felix-eray/ESP32_blAudio_lite/KiCad/ESP32_blAudio_portable.kicad_pcb

## KiCad design KiCad/ESP32_blAudio_portable.kicad_pcb (2022-10-03)

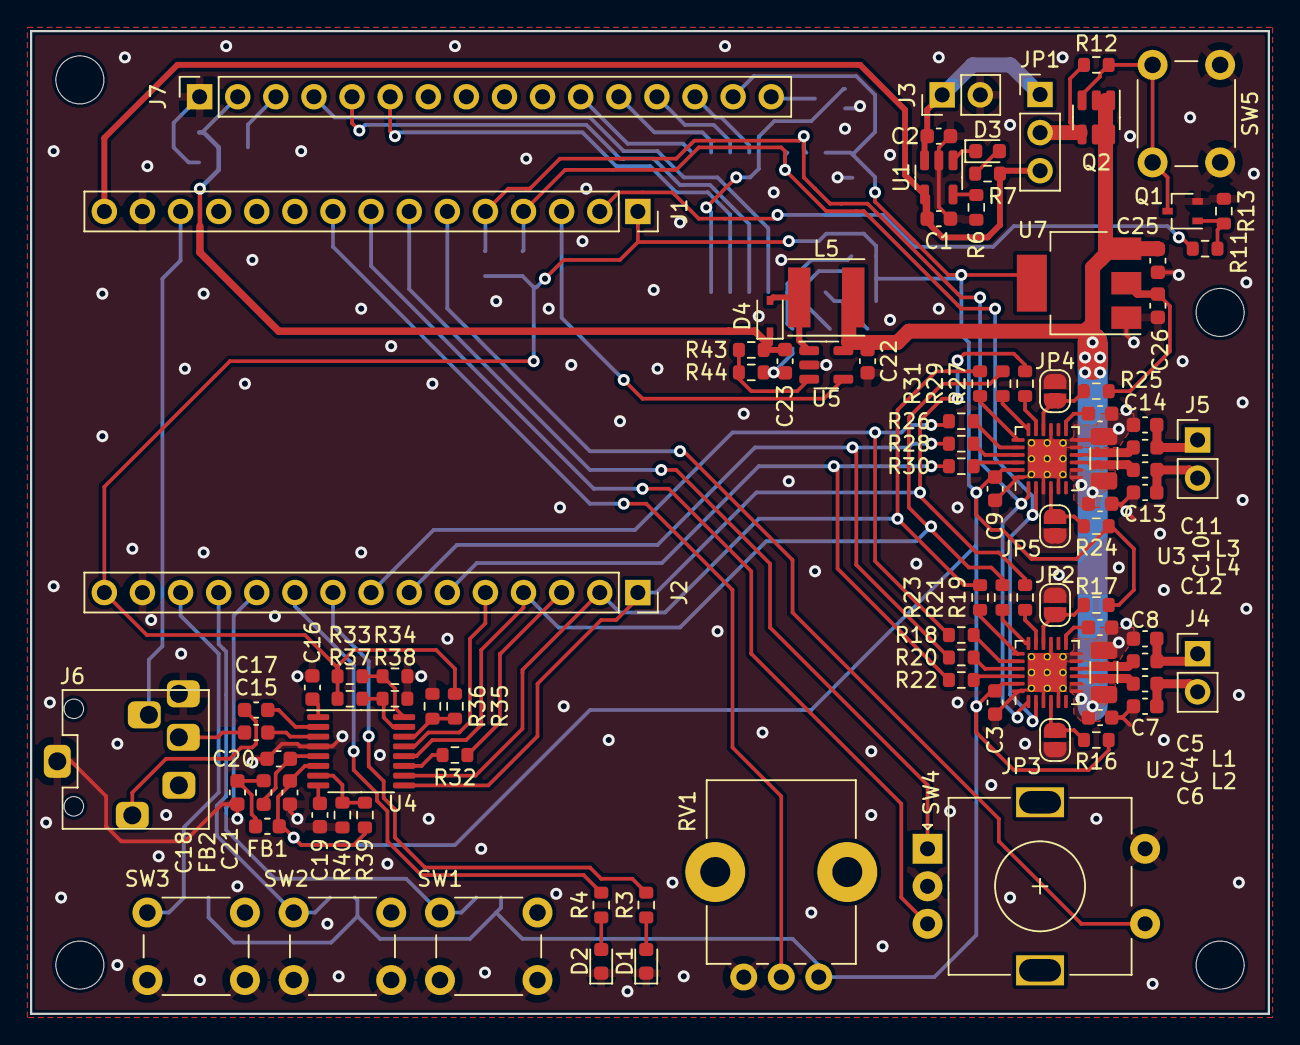
[picture p6: board ESP32_blAudio_portable.kicad_pcb from above]

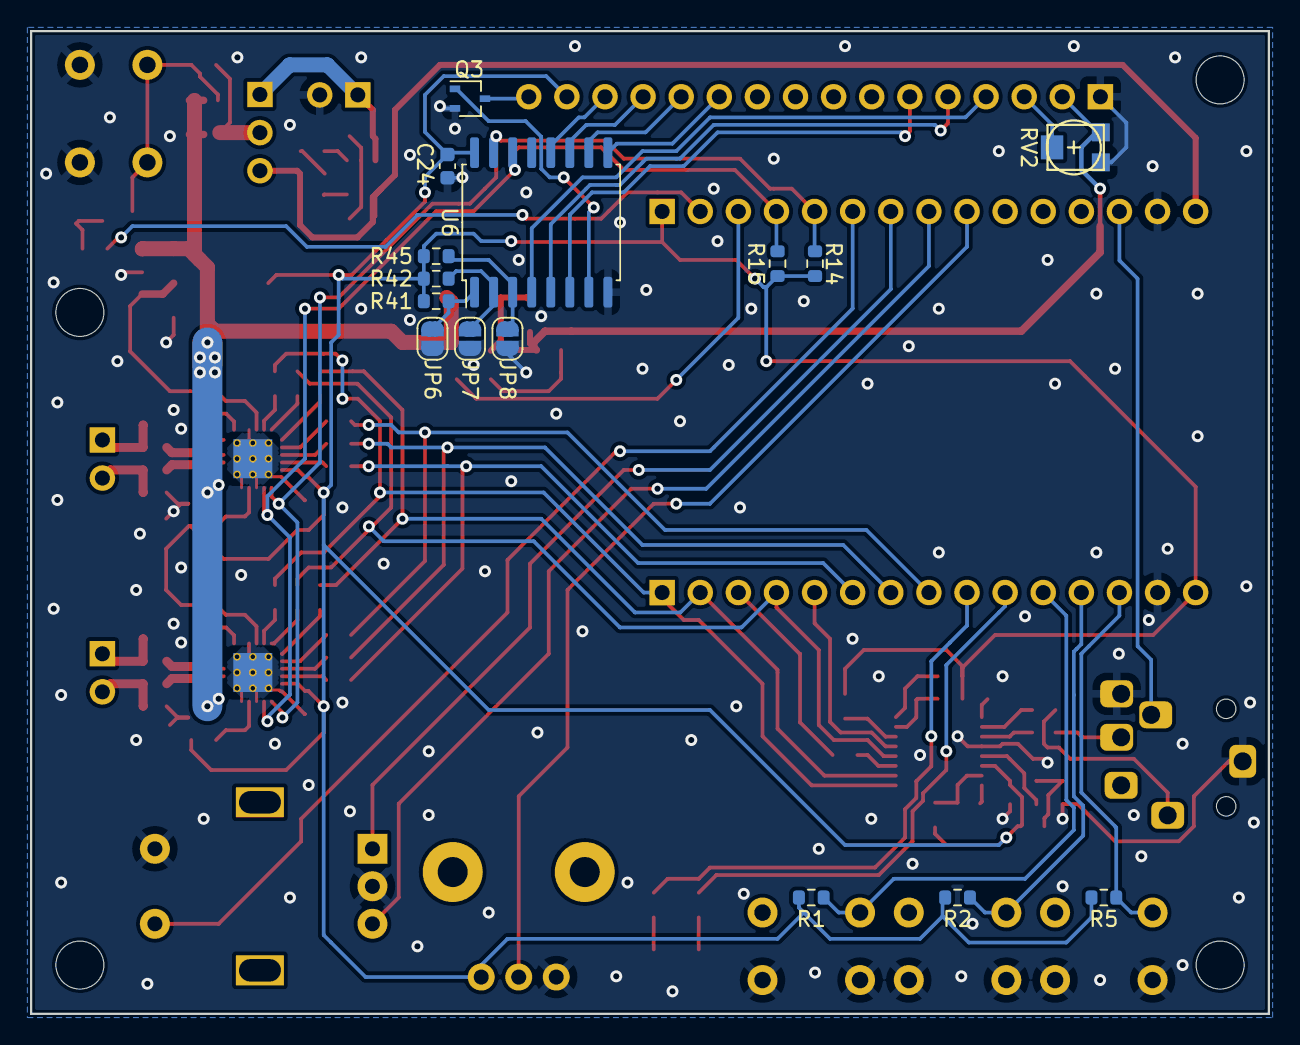
[picture p7: board ESP32_blAudio_portable.kicad_pcb from below]

Board: 2 copper layers, 82.5 x 65.5 mm, 111 parts (15 on the bottom side), 90 nets.

Parts:
C1, C2, C22, C23, C24, C25, C26: 1u; C_0603_1608Metric
C3, C5, C6, C7, C8, C9, C11, C12, C13, C14: 100n; C_0603_1608Metric
C4, C10: 22u; C_1206_3216Metric
C15, C17: 10µ; C_0603_1608Metric
C16, C18, C19, C21: 1µ; C_0603_1608Metric
C20: 220n; C_0603_1608Metric
D1, D2, D3: LED; LED_0603_1608Metric
D4: 30V 1A; D_SOD-323
FB1, FB2: 600R; L_0603_1608Metric
J1, J2: Conn_01x15_Male; PinSocket_1x15_P2.54mm_Vertical
J3, J4, J5: Conn_01x02_Male; PinHeader_1x02_P2.54mm_Vertical
J6: ASJ-99H
J7: Conn_01x16_Female; PinSocket_1x16_P2.54mm_Vertical
JP1: Jumper_3_Open; PinHeader_1x03_P2.54mm_Vertical
JP2, JP3, JP4, JP5: SJ; SolderJumper-2_P1.3mm_Open_RoundedPad1.0x1.5mm
JP6, JP7, JP8: SolderJumper_2_Open; SolderJumper-2_P1.3mm_Open_RoundedPad1.0x1.5mm
L1, L2, L3, L4: L; L_0603_1608Metric
L5: 33u; L_Taiyo-Yuden_NR-50xx
Q1, Q3: 2N7002; SOT-323_SC-70
Q2: Q_PMOS_DGS; SOT-23-6
R1, R2, R5, R6, R7, R12, R13, R14, R15, R43, R44: 10k; R_0603_1608Metric
R3, R4: 120R; R_0603_1608Metric
R11: 100R; R_0603_1608Metric
R16, R17, R24, R25, R41, R42, R45: 110k; R_0603_1608Metric
R18, R19, R20, R21, R22, R23, R26, R27, R28, R29, R30, R31: 22R; R_0603_1608Metric
R32, R33, R34, R35, R36, R37, R38, R39, R40: R; R_0603_1608Metric
RV1: PT01; Potentiometer_Bourns_PTV09A-1_Single_Vertical
RV2: TC33X_10k; trimmer_Bourns_tc33x
SW1, SW2, SW3, SW5: TS02; SW_PUSH_6mm_H5mm
SW4: PEC12R; RotaryEncoder_Alps_EC11E-Switch_Vertical_H20mm
U1: MCP73831-2-OT; SOT-23-5
U2, U3: TFA9879HN; HVQFN-24-1EP_4x4mm_P0.5mm_EP2.6x2.6mm_ThermalVias
U4: AK5720VT; TSSOP-16_4.4x5mm_P0.65mm
U5: AP3012; SOT-23-5
U6: PCF8574; SOIC-16W_7.5x10.3mm_P1.27mm
U7: NCP1117-3.3_SOT223; SOT-223-3_TabPin2

Connections:
+3V3: C3.1, C9.1, C21.2, C24.1, C26.1, FB1.2, J1.1, J2.15, J7.15, R1.2, R2.2, R5.2, R14.1, R15.1, R16.1, R17.1, R24.1, R25.1, R33.1, R35.1, R37.1, R39.1, R41.2, R42.2, R45.2, RV1.1, U2.23 (VDD), U3.23 (VDD), U4.6 (VD), U6.16 (VDD), U7.2 (VO)
+5C: C23.1, D4.1 (K), J7.2, R43.2, RV2.3
+5V: C1.1, J1.15, JP1.3 (B), R7.2, U1.4 (VDD)
+BATT: C2.1, J3.1, JP1.1 (A), U1.3 (VBAT)
+VDC: C4.1, C6.1, C10.1, C12.1, C22.1, C25.1, L5.1, Q2.1 (D), U2.7 (VDDP), U2.8 (VDDP), U3.7 (VDDP), U3.8 (VDDP), U5.5 (IN), U7.3 (VI)
/3-5_SW: J1.13, J6.4
/ANA_VOL: J1.9, RV1.2
/BTTN1: J2.11, R1.1, SW1.2
/BTTN2: J2.12, R2.1, SW2.2
/BTTN3: J2.13, R5.1, SW3.2
/Display/LCD_BCKL_EN: Q3.1 (G), U6.7 (P3)
/Display/LCD_D4: J7.11, U6.9 (P4)
/Display/LCD_D5: J7.12, U6.10 (P5)
/Display/LCD_D6: J7.13, U6.11 (P6)
/Display/LCD_D7: J7.14, U6.12 (P7)
/Display/LCD_E: J7.6, U6.6 (P2)
/Display/LCD_RS: J7.4, U6.4 (P0)
/Display/LCD_R/~W: J7.5, U6.5 (P1)
/ENC_A: J1.7, SW4.A
/ENC_B: J1.8, SW4.B
/ENC_SW: J1.6, SW4.S1
/EN_5V: J1.3, U5.4 (~SHDN)
/LED1: J2.9, R3.2
/LED2: J2.10, R4.2
/LRCK1: J2.6, R22.1, R30.1
/LRCK2: J2.2, R23.1, R31.1, U4.10 (LRCLK)
/MCLK: J2.3, R32.2
/PWR_ON: J1.2, R11.1
/SCK1: J2.7, R20.1, R28.1
/SCK2: J2.4, R21.1, R29.1, U4.12 (BICK)
/SCL: J1.4, R15.2, U2.2 (SCL), U3.2 (SCL), U6.14 (SCL)
/SDA: J1.5, R14.2, U2.1 (SDA), U3.1 (SDA), U6.15 (SDA)
/SDI1: J2.8, R18.1, R26.1
/SDI2: J2.1, R19.1, R27.1, U4.9 (SDTO)
/~PDN: J2.5, U4.13 (~PDN)
GND: C1.2, C2.2, C3.2, C4.2, C5.2, C6.2, C7.2, C8.2, C9.2, C10.2, C11.2, C12.2, C13.2, C14.2, C16.2, C18.1, C19.2, C20.1, C21.1, C22.2, C23.2, C24.2, C25.2, C26.2, D1.1 (K), D2.1 (K), J1.14, J2.14, J3.2, J6.5, J6.S, J7.1, JP2.1 (A), JP3.1 (A), JP4.1 (A), JP5.1 (A), JP6.1 (A), JP7.1 (A), JP8.1 (A), Q1.2 (S), Q3.2 (S), R6.1, R13.2, R34.2, R36.2, R38.2, R40.2, R44.1, RV1.3, RV2.1, SW1.1, SW2.1, SW3.1, SW4.C, SW4.S2, SW5.1, U1.2 (VSS), U2.3 (TEST1), U2.5 (TEST3), U2.11 (GNDP), U2.12 (GNDP), U2.15 (TEST2), U2.24 (GNDD), U2.25 (EP), U3.3 (TEST1), U3.5 (TEST3), U3.11 (GNDP), U3.12 (GNDP), U3.15 (TEST2), U3.24 (GNDD), U3.25 (EP), U4.4 (VSS), U5.2 (GND), U6.8 (VSS), U7.1 (GND)
unnamed: C5.1, U2.13 (STABA)
unnamed: C7.1, J4.2, L2.2
unnamed: C8.1, J4.1, L1.2
unnamed: C11.1, U3.13 (STABA)
unnamed: C13.1, J5.2, L4.2
unnamed: C14.1, J5.1, L3.2
unnamed: C15.1, U4.3 (LIN)
unnamed: C15.2, J6.T
unnamed: C16.1, U4.1 (VCOM)
unnamed: C17.1, U4.2 (RIN)
unnamed: C17.2, J6.R
unnamed: C18.2, FB1.1, FB2.2
unnamed: C19.1, U4.8 (REGO)
unnamed: C20.2, FB2.1, U4.5 (VA)
unnamed: D1.2 (A), R3.1
unnamed: D2.2 (A), R4.1
unnamed: D3.1 (K), U1.1 (STAT)
unnamed: D3.2 (A), R7.1
unnamed: D4.2 (A), L5.2, U5.1 (SW)
unnamed: J7.3, RV2.2
unnamed: J7.16, Q3.3 (D)
unnamed: JP1.2 (C), Q2.3 (S), R12.1
unnamed: JP2.2 (B), R17.2, U2.16 (ADSEL1)
unnamed: JP3.2 (B), R16.2, U2.4 (ADSEL2)
unnamed: JP4.2 (B), R25.2, U3.16 (ADSEL1)
unnamed: JP5.2 (B), R24.2, U3.4 (ADSEL2)
unnamed: JP6.2 (B), R41.1, U6.1 (A0)
unnamed: JP7.2 (B), R42.1, U6.2 (A1)
unnamed: JP8.2 (B), R45.1, U6.3 (A2)
unnamed: L1.1, U2.10 (OUTA)
unnamed: L2.1, U2.9 (OUTB)
unnamed: L3.1, U3.10 (OUTA)
unnamed: L4.1, U3.9 (OUTB)
unnamed: Q1.1 (G), R11.2, R13.1
unnamed: Q1.3 (D), Q2.2 (G), R12.2, SW5.2
unnamed: R6.2, U1.5 (PROG)
unnamed: R18.2, U2.20 (SDI1)
unnamed: R19.2, U2.17 (SDI2)
unnamed: R20.2, U2.21 (SCK1)
unnamed: R21.2, U2.18 (SCK2)
unnamed: R22.2, U2.22 (LRCK1)
unnamed: R23.2, U2.19 (LRCK2)
unnamed: R26.2, U3.20 (SDI1)
unnamed: R27.2, U3.17 (SDI2)
unnamed: R28.2, U3.21 (SCK1)
unnamed: R29.2, U3.18 (SCK2)
unnamed: R30.2, U3.22 (LRCK1)
unnamed: R31.2, U3.19 (LRCK2)
unnamed: R32.1, U4.11 (MCLK)
unnamed: R33.2, R34.1, U4.16 (CKS)
unnamed: R35.2, R36.1, U4.14 (DIF/TDMI)
unnamed: R37.2, R38.1, U4.15 (FSEL)
unnamed: R39.2, R40.1, U4.7 (GSEL)
unnamed: R43.1, R44.2, U5.3 (FB)
