felix-eray/ESP32_blAudio_lite/(commit log)

2022-09-30 -initial commit
    [AK5720.kicad_sch, ESP32_blAudio_portable.kicad_pcb, ESP32_blAudio_portable.kicad_sch, TFA9879.kicad_sch, display.kicad_sch]
2022-09-30 -associated footprints to more specific components -added manufacturer and part series info to more specific components
    [AK5720.kicad_sch, ESP32_blAudio_portable.kicad_pcb, ESP32_blAudio_portable.kicad_sch, display.kicad_sch]
2022-09-30 -layout work
    [AK5720.kicad_sch, ESP32_blAudio_portable.kicad_pcb, ESP32_blAudio_portable.kicad_sch]
2022-10-02 -layout largely finished, some finishing touches needed
    [ESP32_blAudio_portable.kicad_pcb, ESP32_blAudio_portable.kicad_sch]
2022-10-02 -fixed .gitignore for the kicad's project backup files
2022-10-03 -First board version ready to order
    [ESP32_blAudio_portable-B_Cu.gbl, ESP32_blAudio_portable-B_Mask.gbs, ESP32_blAudio_portable-B_Silkscreen.gbo, ESP32_blAudio_portable-Edge_Cuts.gm1, ESP32_blAudio_portable-F_Cu.gtl, ESP32_blAudio_portable-F_Mask.gts, ESP32_blAudio_portable-F_Silkscreen.gto, ESP32_blAudio_portable-NPTH-drl_map.gbr]
2022-10-16 -boards on hand atm, assembling first board and finalizing used component values
    [AK5720.kicad_sch, ESP32_blAudio_portable.kicad_sch, display.kicad_sch]
2022-10-16 -More HW updates and corrections -basic FW
    [ESP32_blAudio_portable.kicad_sch, display.kicad_sch]
2022-10-17 -updated schematic component values, updated schematic PDF -added simple bass and treble control for the TF9879 amp
    [ESP32_blAudio_portable.kicad_sch, TFA9879.kicad_sch, display.kicad_sch]
2022-10-20 -added treble and bass control function and added some delay to power-up sequence to hopefully fix weird power-on issue with ADC or amp, which causes this weird bump thumping on power-up
    [main.cpp]
2022-10-23 -added pin out map for the ESP32 module -Long button 1 press now toggles between bluetooth and 3,5mm jack as audio sources
2022-10-24 -added shutdown board to long press of button 3
2022-10-24 -added potential library for driving the character LCD through the PCF8574 I2C-IO expander
2022-10-29 -LCD driver library through PCF8574A I2C-IO expander added
2022-10-31 -fixed some variable related shenanigans in the button press function
    [main.cpp]
